szbk/Plant-Panel/enclosure/stl/kapsul_kelepce_on.stl

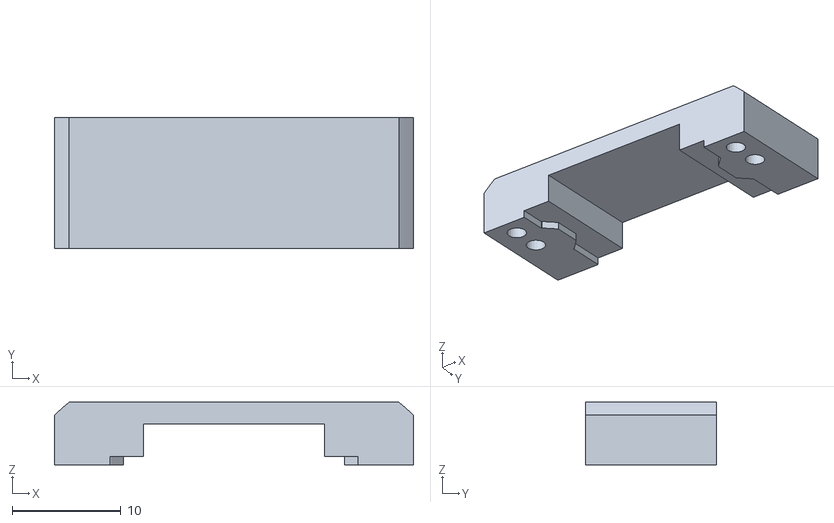
[picture p4: CAD file, 2026-11-08]
enclosure/stl/kapsul_kelepce_on.stl
33.0 x 12.0 x 5.75
