szbk/Plant-Panel/enclosure/stl/kapsul_alt_test.stl

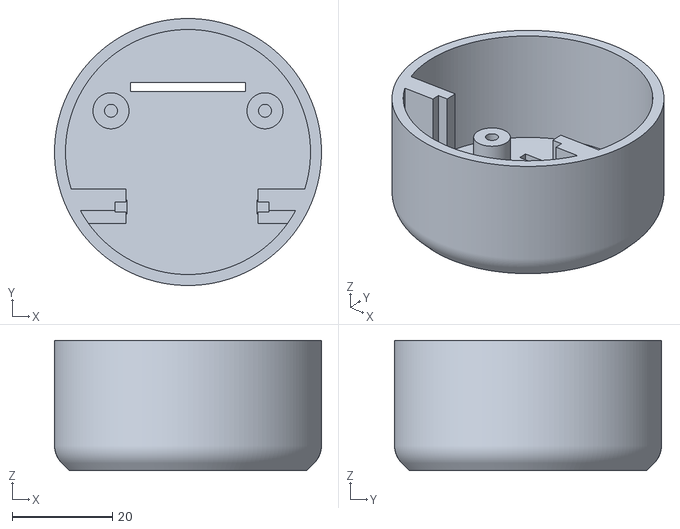
[picture p5: CAD file, 2026-11-08]
enclosure/stl/kapsul_alt_test.stl
53.4 x 53.4 x 26.0
