szbk/Plant-Panel/enclosure/stl/centik_test_taragi.stl

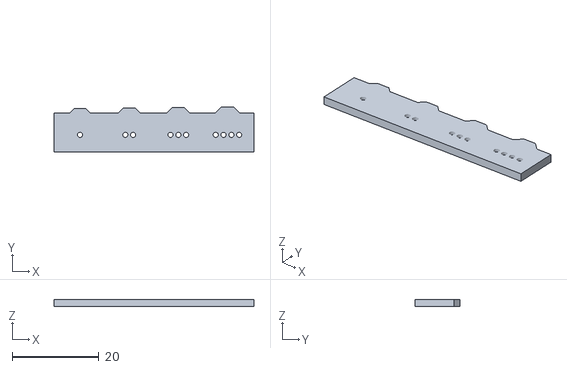
[picture p6: CAD file, 2026-11-08]
enclosure/stl/centik_test_taragi.stl
46.0 x 10.4 x 1.60
