szbk/Plant-Panel/enclosure/stl/kapsul_cap.stl

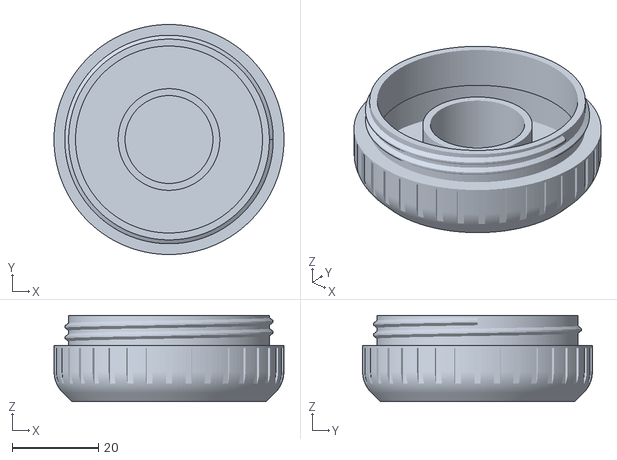
[picture p7: CAD file, 2026-11-08]
enclosure/stl/kapsul_cap.stl
53.4 x 53.4 x 20.0
