szbk/Plant-Panel/enclosure/stl/kapsul_body.stl

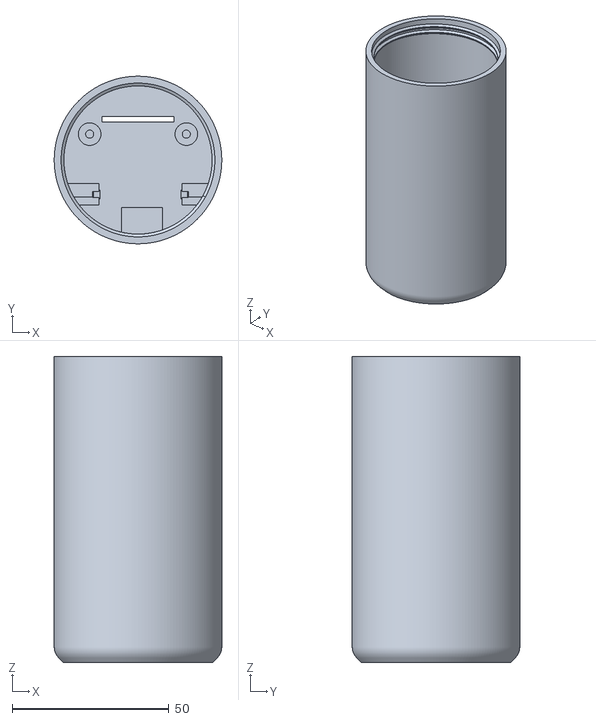
[picture p8: CAD file, 2026-11-08]
enclosure/stl/kapsul_body.stl
53.4 x 53.4 x 97.5
