szbk/Plant-Panel/enclosure/stl/kapsul_ust_test.stl

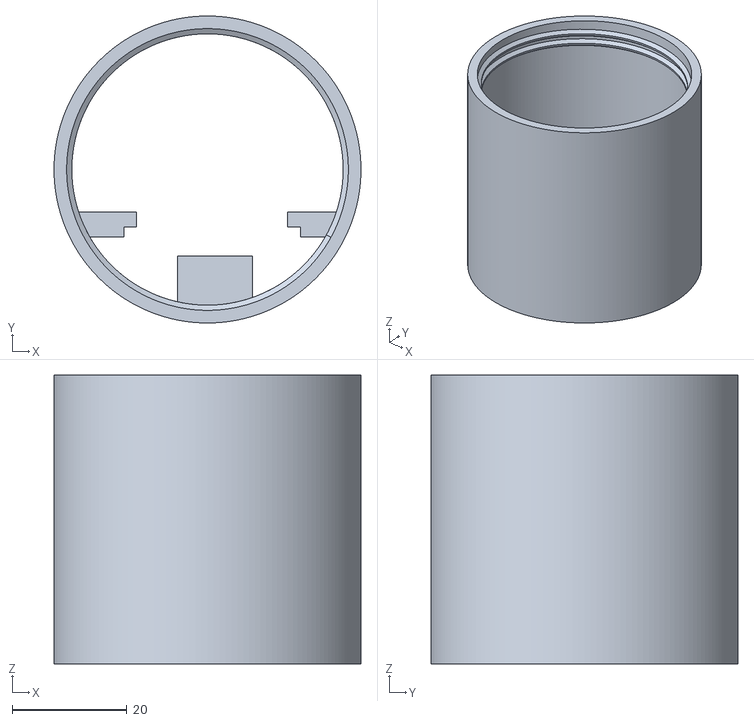
[picture p9: CAD file, 2026-11-08]
enclosure/stl/kapsul_ust_test.stl
53.4 x 53.4 x 50.2
