szbk/Plant-Panel/enclosure/stl/kapsul_kelepce_arka.stl

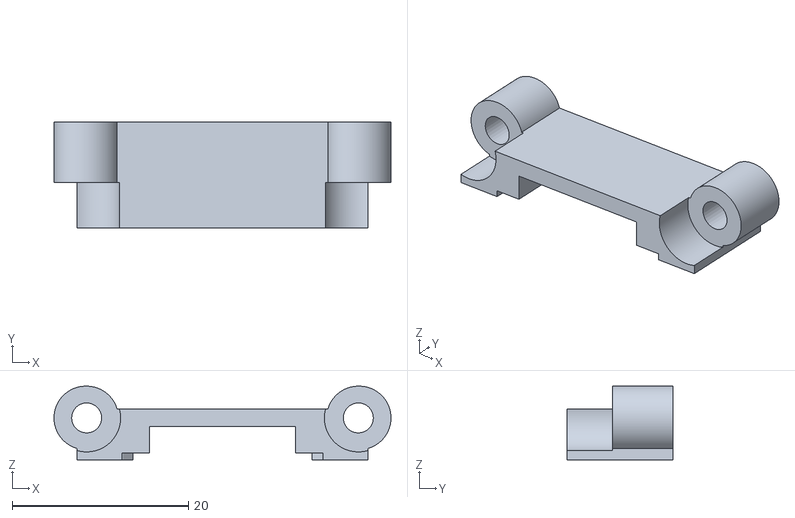
[picture p10: CAD file, 2026-11-08]
enclosure/stl/kapsul_kelepce_arka.stl
38.2 x 12.0 x 8.35
